CircuitosCreativos/AlzheimerAss/Eagle/Asistente_Alzhaimer(esquematico).png

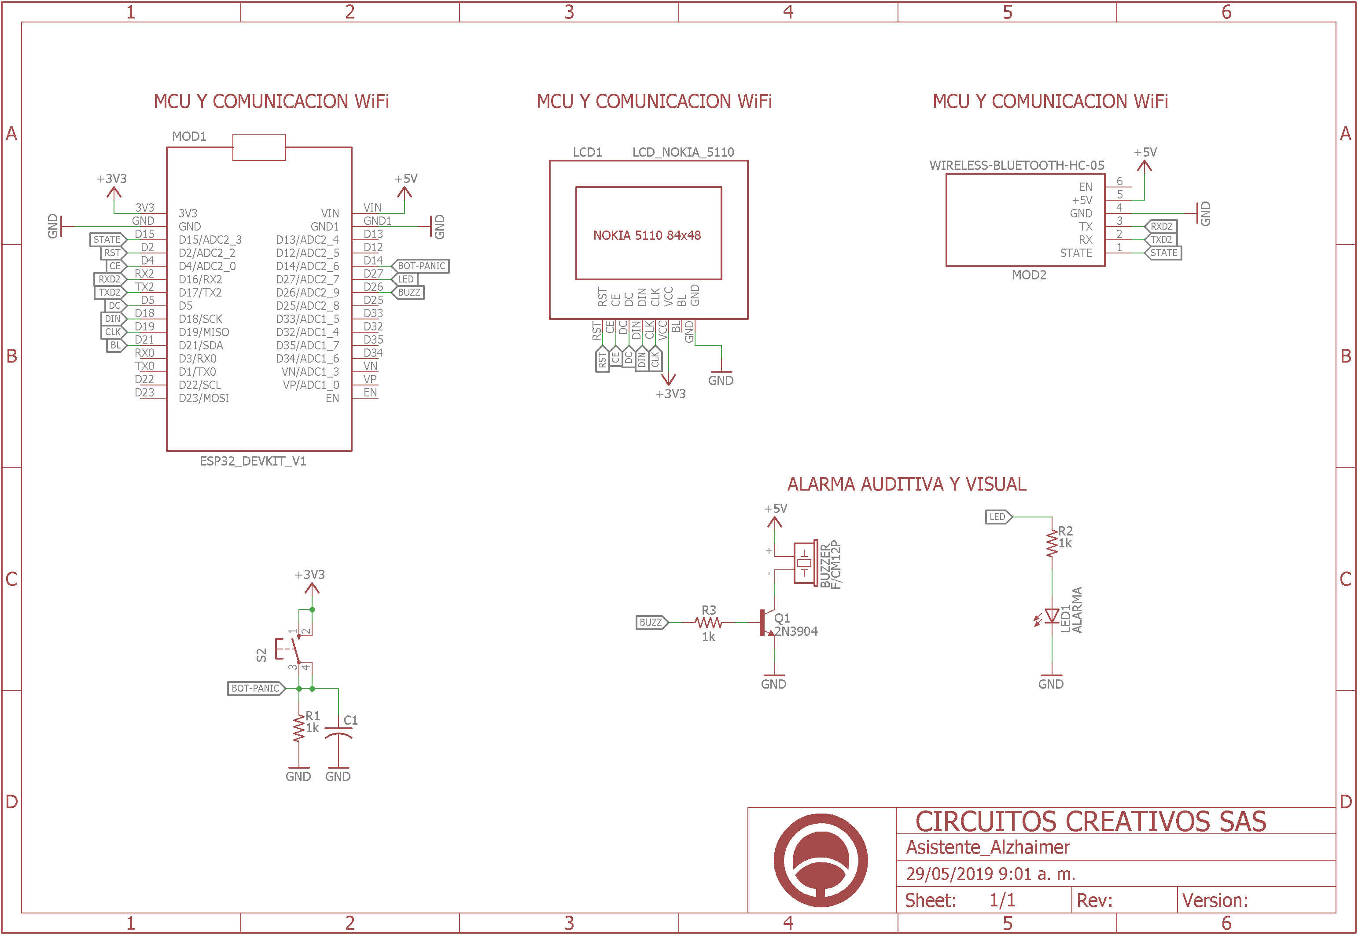
Eagle/Asistente_Alzhaimer(esquematico).png
