CircuitosCreativos/AlzheimerAss/Eagle/Asistente_Alzhaimer(PCB).png

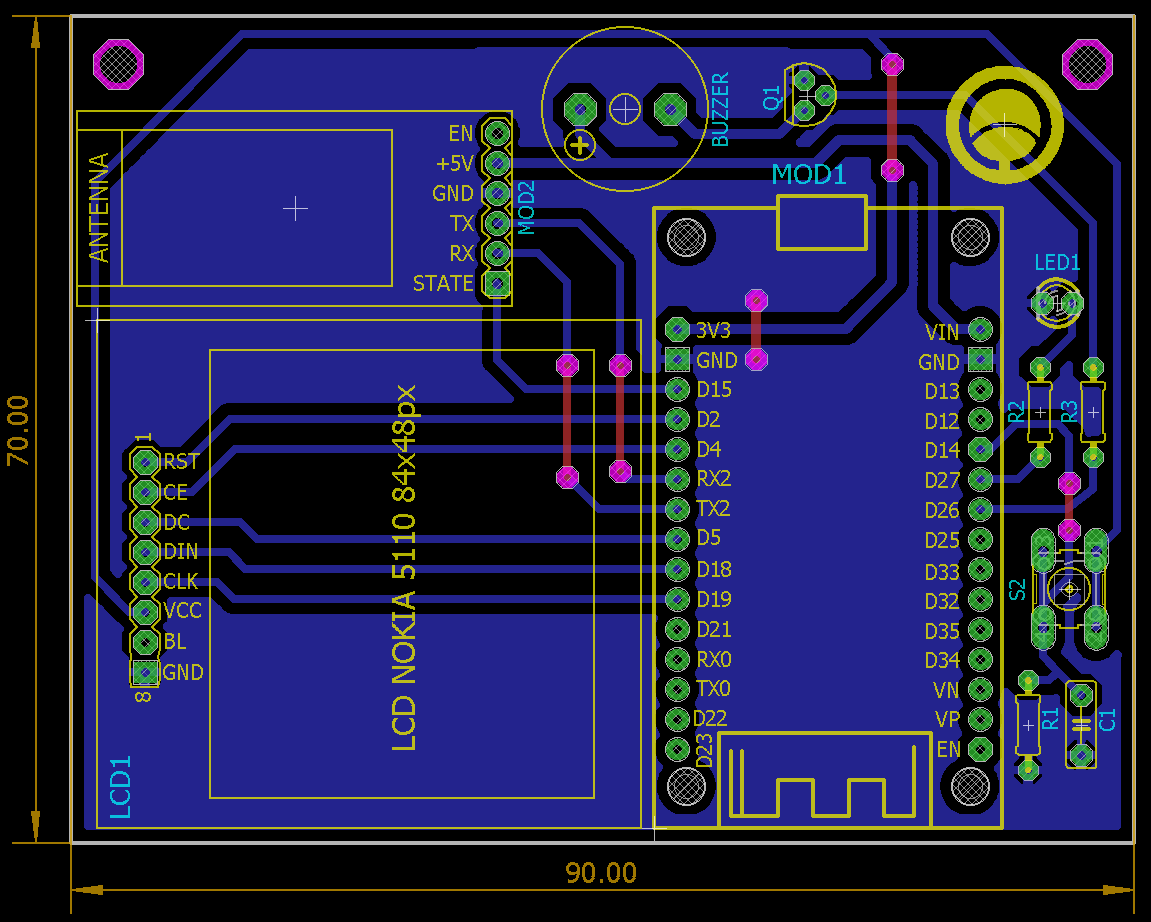
Eagle/Asistente_Alzhaimer(PCB).png
