CircuitosCreativos/AlzheimerAss/Eagle/Asistente_Alzhaimer.brd

## EAGLE design Eagle/Asistente_Alzhaimer.brd (2019-06-05)

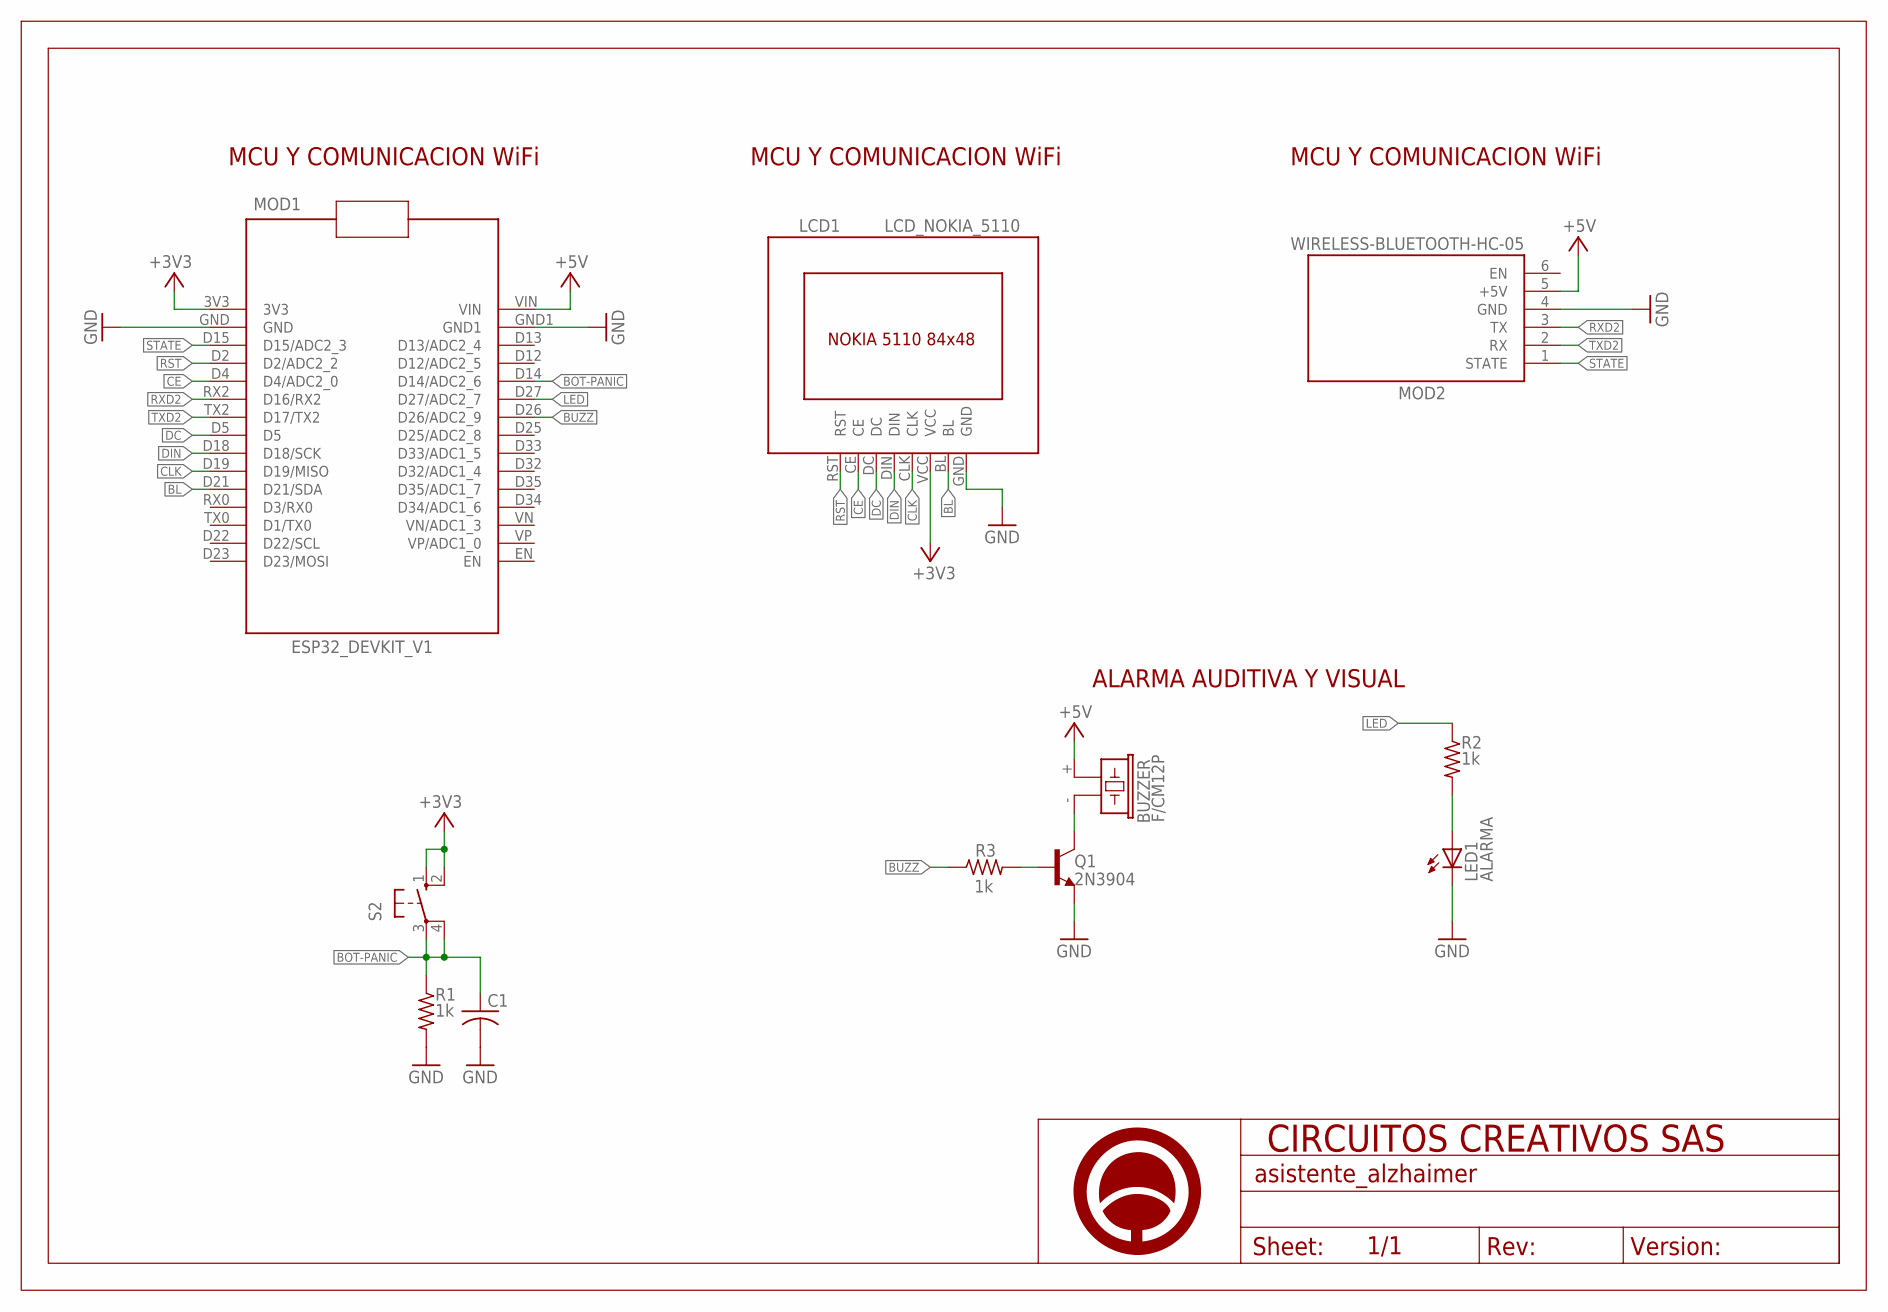
[picture p3: schematic Asistente_Alzhaimer.sch]

Parts:
BUZZER: F/CM12P
C1: C-US050-025X075; C050-025X075
LCD1: LCD_NOKIA_5110; NOKIA_5110_THT
LED1: ALARMA; LED3MM
MOD1: ESP32_DEVKIT_V1
MOD2: WIRELESS-BLUETOOTH-HC-05
Q1: 2N3904; TO-92
R1, R2, R3: 1k; 0204/7
S2: 10-XX; B3F-10XX
U$1: A4_HORIZONTAL; LOGO

Connections:
+3V3: LCD1.VCC, MOD1.3V3, S2.1 (S), S2.2 (S1)
+5V: BUZZER.+ (1), MOD1.VIN, MOD2.5 (+5V)
BL: LCD1.BL, MOD1.D21 (D21/SDA)
BOT-PANIC: C1.1, MOD1.D14 (D14/ADC2_6), R1.1, S2.3, S2.4 (P1)
BUZZ: MOD1.D26 (D26/ADC2_9), R3.1
CE: LCD1.CE, MOD1.D4 (D4/ADC2_0)
CLK: LCD1.CLK, MOD1.D19 (D19/MISO)
DC: LCD1.DC, MOD1.D5
DIN: LCD1.DIN, MOD1.D18 (D18/SCK)
GND: C1.2, LCD1.GND, LED1.K (C), MOD1.GND, MOD1.GND1, MOD2.4 (GND), Q1.1 (E), R1.2
LED: MOD1.D27 (D27/ADC2_7), R2.1
unnamed: LED1.A, R2.2
unnamed: Q1.2 (B), R3.2
unnamed: BUZZER.- (2), Q1.3 (C)
RST: LCD1.RST, MOD1.D2 (D2/ADC2_2)
RXD2: MOD1.RX2 (D16/RX2), MOD2.3 (TX)
STATE: MOD1.D15 (D15/ADC2_3), MOD2.1 (STATE)
TXD2: MOD1.TX2 (D17/TX2), MOD2.2 (RX)

Notes on the sheet:
ALARMA AUDITIVA Y VISUAL
MCU Y COMUNICACION WiFi

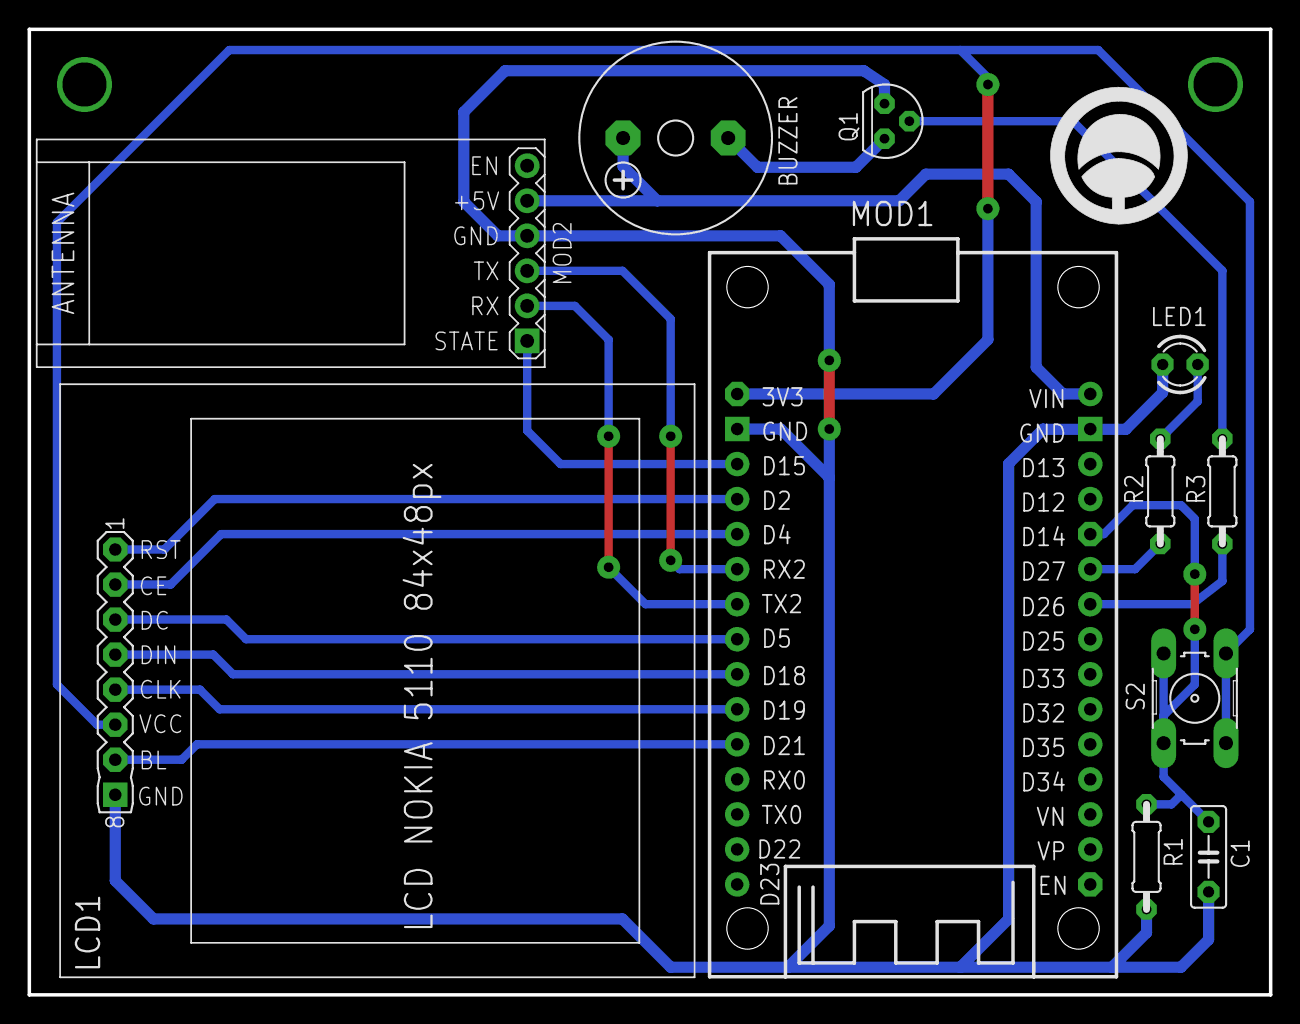
[picture p4: board Asistente_Alzhaimer.brd from above]

Board: 2 copper layers, 90.0 x 70.0 mm, 12 parts (0 on the bottom side), 18 nets.
