CircuitosCreativos/AlzheimerAss/(commit log)

2019-05-10 Commit inicial, cambiar MKR1000 por ESP32
    [Asistente_Alzhaimer.sch]
2019-05-10 Completado comunicacion basica con blynk ESP32
2019-05-11 Conexion exitosa con sensor Hub nano
2019-05-11 Add lcd mensaje conexion exitosa y error
    [Hub_nano.ino, Visual.ino]
2019-05-11 Completado comunicacion basica con todo el Hardware
2019-05-14 Add menuAlarmas para control de estados
2019-05-14 Add alarma por temperatura
2019-05-14 Revert "Add alarma por temperatura"
    This reverts commit 0443742994e362710b3b0a837980e471c1c06687.
    [Alarmas.ino, AlzheimerAss.ino, BlynkApp.ino, Visual.ino]
2019-05-15 SCH con ESP32 al 50%
    [Asistente_Alzhaimer.sch]
2019-06-05 Terminado SCH y BRD
    [Asistente_Alzhaimer.brd, Asistente_Alzhaimer.sch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]
